J-CLANCY/Project-Thistle/docs/Notes.odt

Notes:

The system takes 5 cycles to complete an instruction, on the 6th clock cycle it resets. The system clock varies from 0.1Hz to 10Hz. The system also has a monostable clock to allow stepping through the program cycle by cycle.

The system starts reading instructions at memory location 0, data memory, stacks etc. will have to be placed somewhere in the middle or end of RAM.

The carry bit will only turn on if either, 1. Both MSBs are 1’s and cause overflow or 2. A is greater than or equal to B when doing a subtraction.

The ALU supports 2’s complement for minus numbers.

DON’T LET THE ALU REGISTERS REACH 127, IT’S A BAD TIME AND NOBODY WANTS IT.
