J-CLANCY/Project-Thistle/docs/modules/Null_Register.odt

Null Register Design

- 8-bit register will all I/P tied low

- Using: 2x 74LS175 → Quad D flip-flop

1x 74LS645 → Octal bus transceiver

- Micro-instructions → NO

Design:

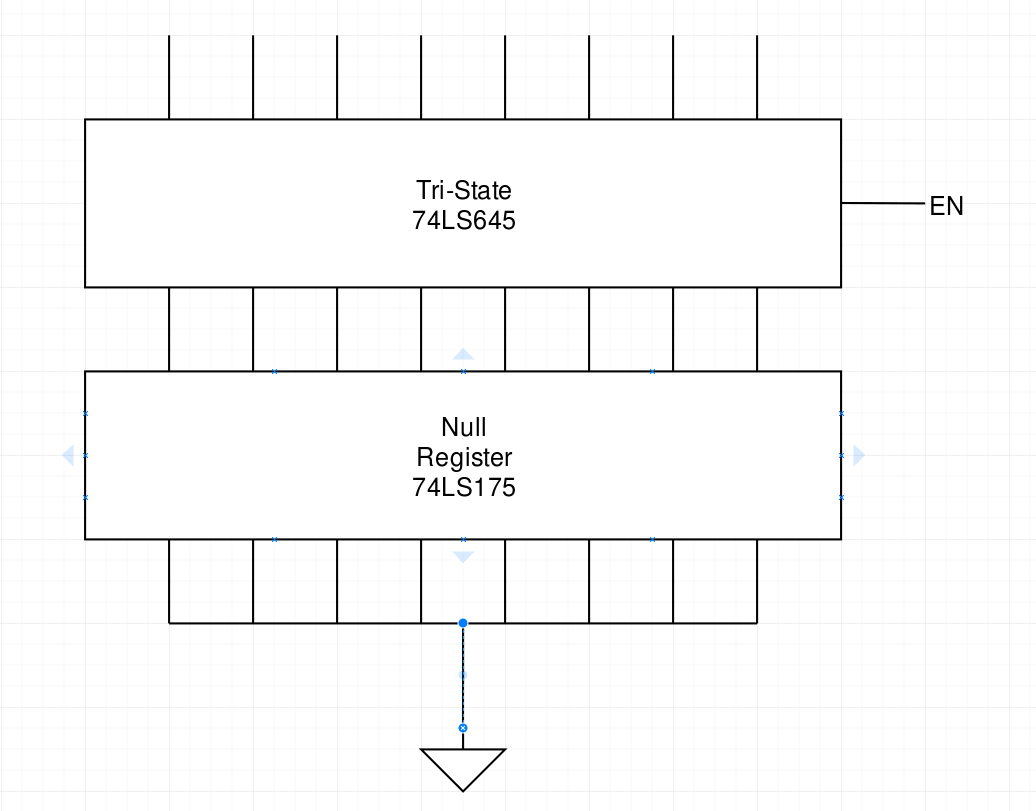
[picture p14: figure]

Build:
