J-CLANCY/Project-Thistle/docs/modules/Program_Counter.odt

Program Counter Design

- Using: 2x 74LS93 → 4-bit Counter

1x 74LS645 → Octal bus transceivers

- Micro-instructions → PI,PO,PE

Diagram:

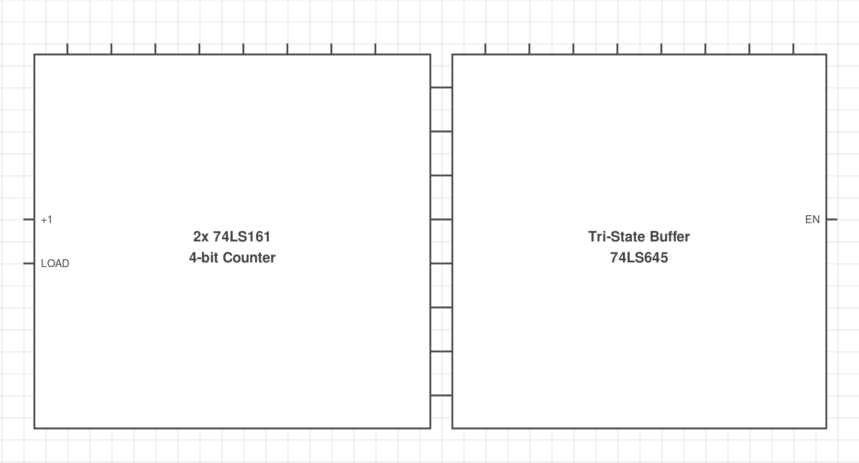
[picture p15: figure]

Build:

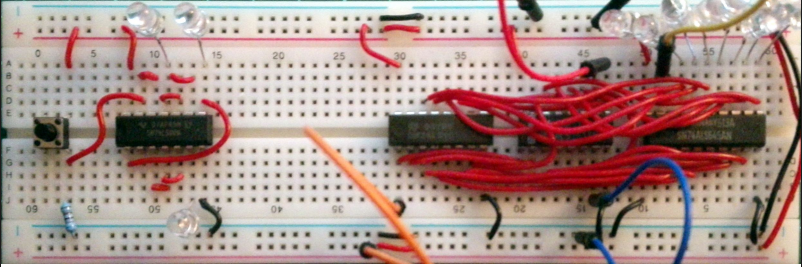
[picture p16: figure]
