J-CLANCY/Project-Thistle/docs/images/ALU/Scanned_20170225-1701.pdf

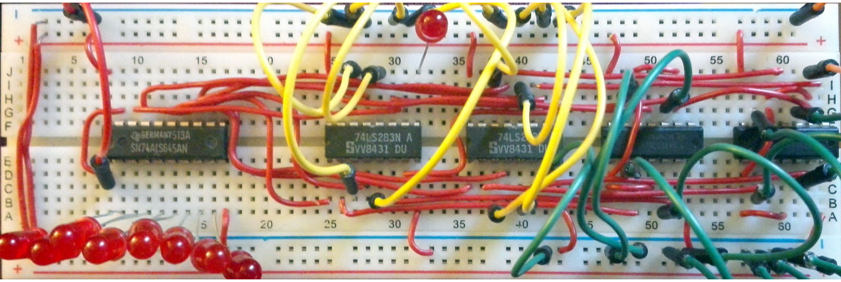
[picture p17: figure]
