J-CLANCY/Project-Thistle/docs/images/ALU/Scanned_20170519-2343.pdf

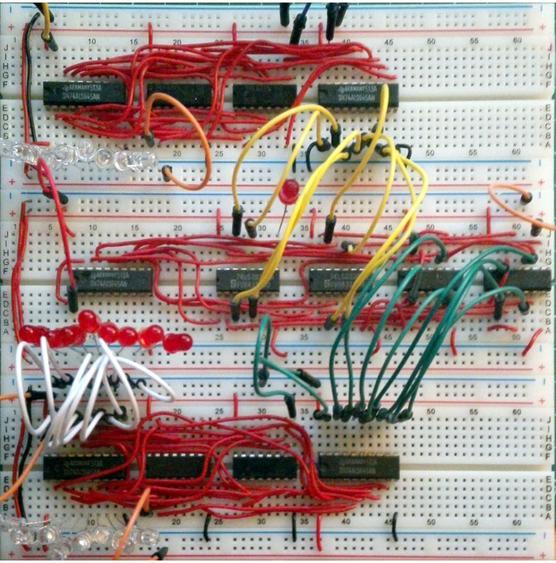
[picture p18: page 1]
