J-CLANCY/Project-Thistle/docs/images/Clock/Scanned_20170119-2244.pdf

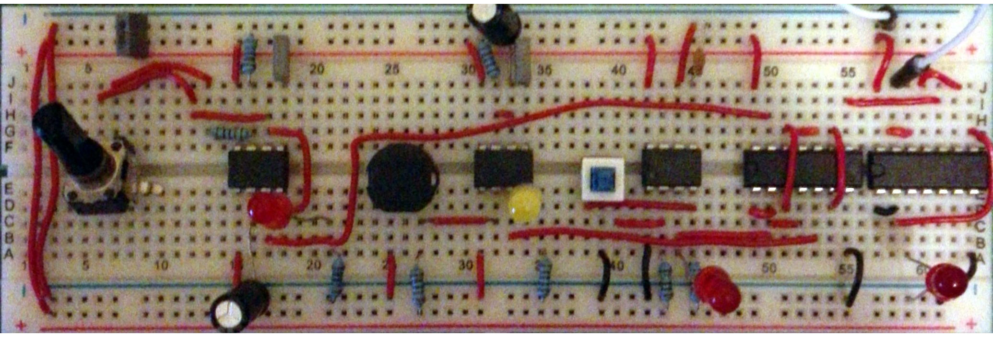
[picture p19: figure]
