J-CLANCY/Project-Thistle/docs/images/I-O/Scanned_20170609-1814.pdf

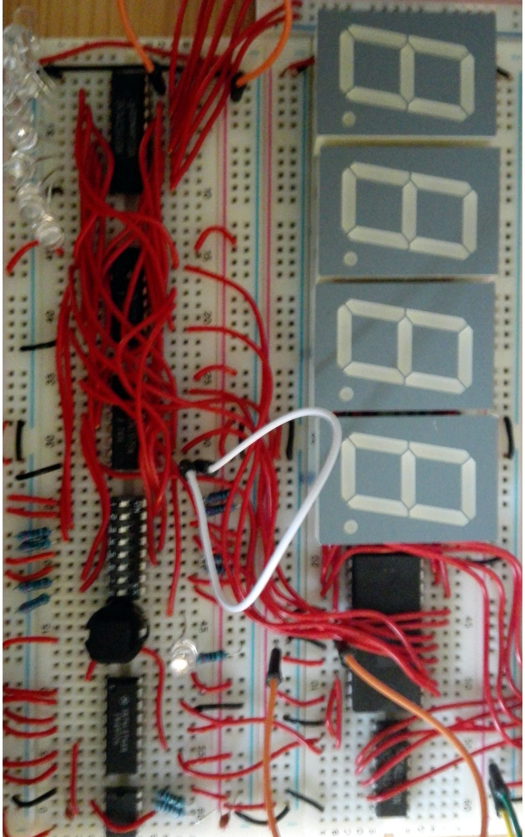
[picture p20: page 1]
