J-CLANCY/Project-Thistle/docs/images/IR-Stepper/Scanned_20170529-2137.pdf

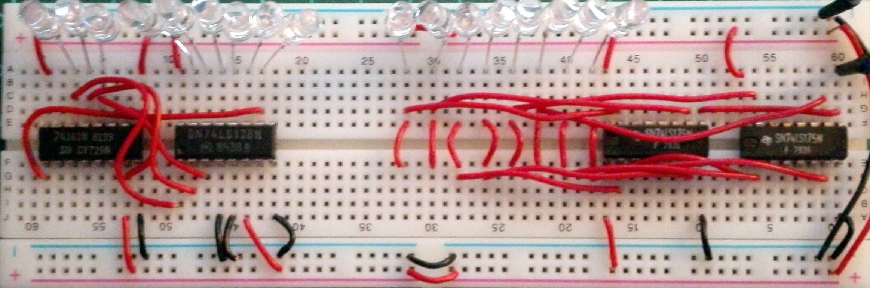
[picture p21: figure]
