J-CLANCY/Project-Thistle/docs/images/Program Counter/Scanned_20170529-2156.pdf

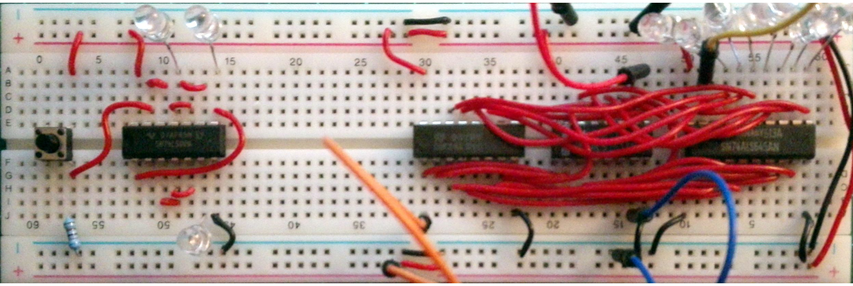
[picture p22: figure]
