J-CLANCY/Project-Thistle/docs/images/RAM/Scanned_20170410-1536.pdf

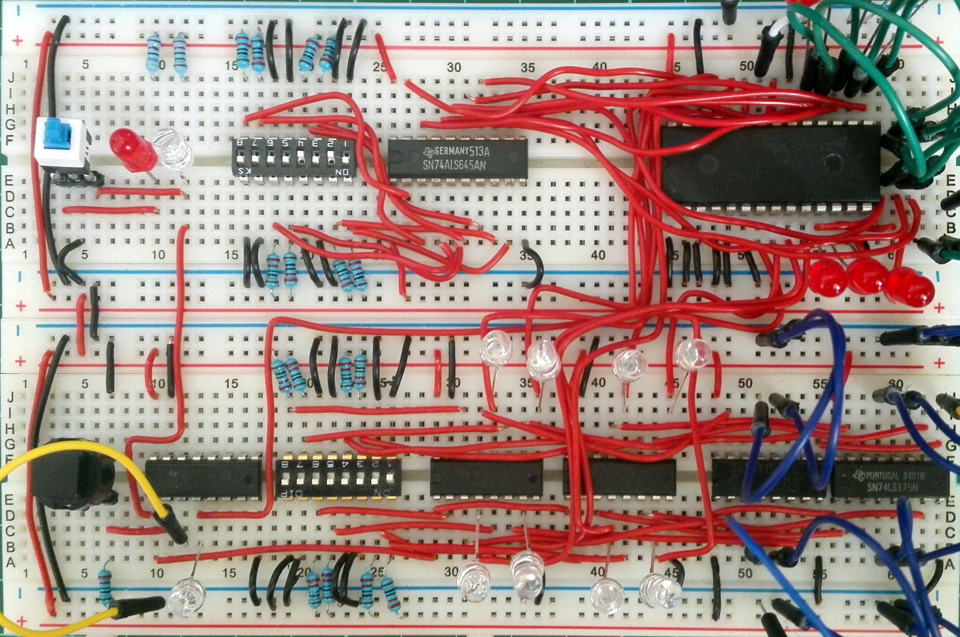
[picture p23: figure]
