J-CLANCY/Project-Thistle/docs/images/Registers/Scanned_20170515-2326.pdf

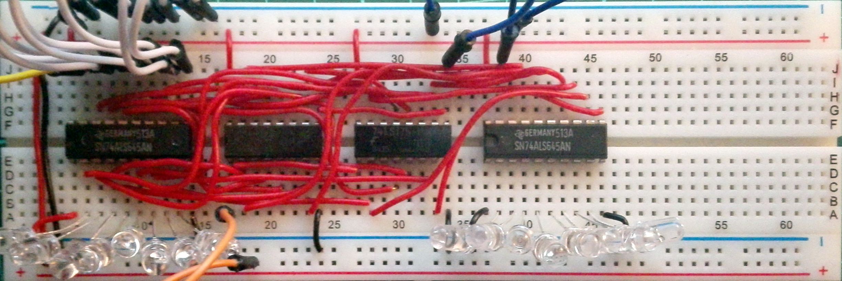
[picture p24: figure]
