J-CLANCY/Project-Thistle/docs/images/Registers/Scanned_20170519-2339.pdf

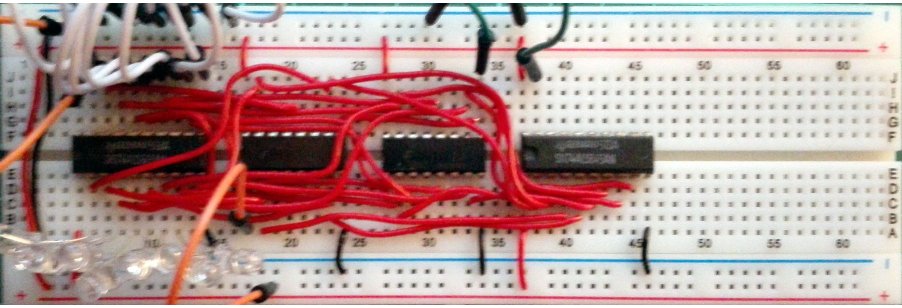
[picture p25: figure]
