J-CLANCY/Project-Thistle/docs/images/Registers/Scanned_20170525-2149.pdf

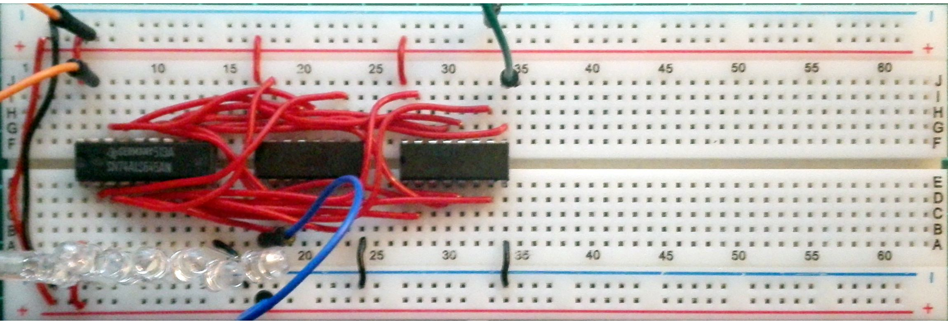
[picture p26: figure]
