J-CLANCY/Project-Thistle/docs/images/Registers/Scanned_20170525-2149(1).pdf

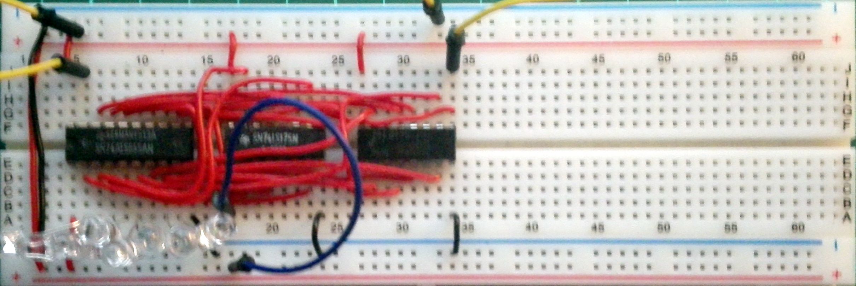
[picture p27: figure]
