J-CLANCY/Project-Thistle/docs/schematics/Project_Thistle.png

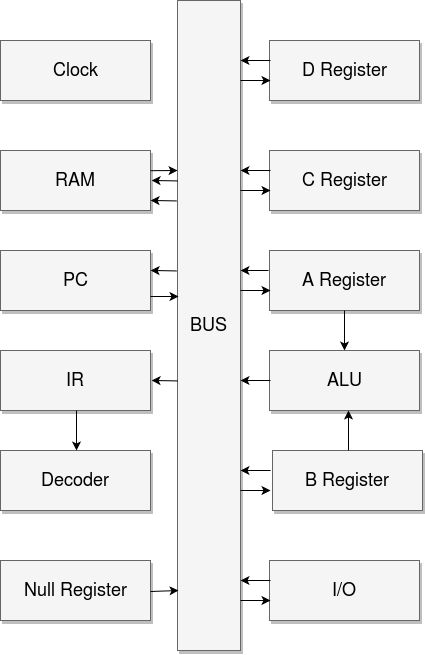
docs/schematics/Project_Thistle.png
